mat-cab/Viridian-Shield/kicad/ViridianShield.kicad_pcb

## KiCad design kicad/ViridianShield.kicad_pcb (2021-05-29)

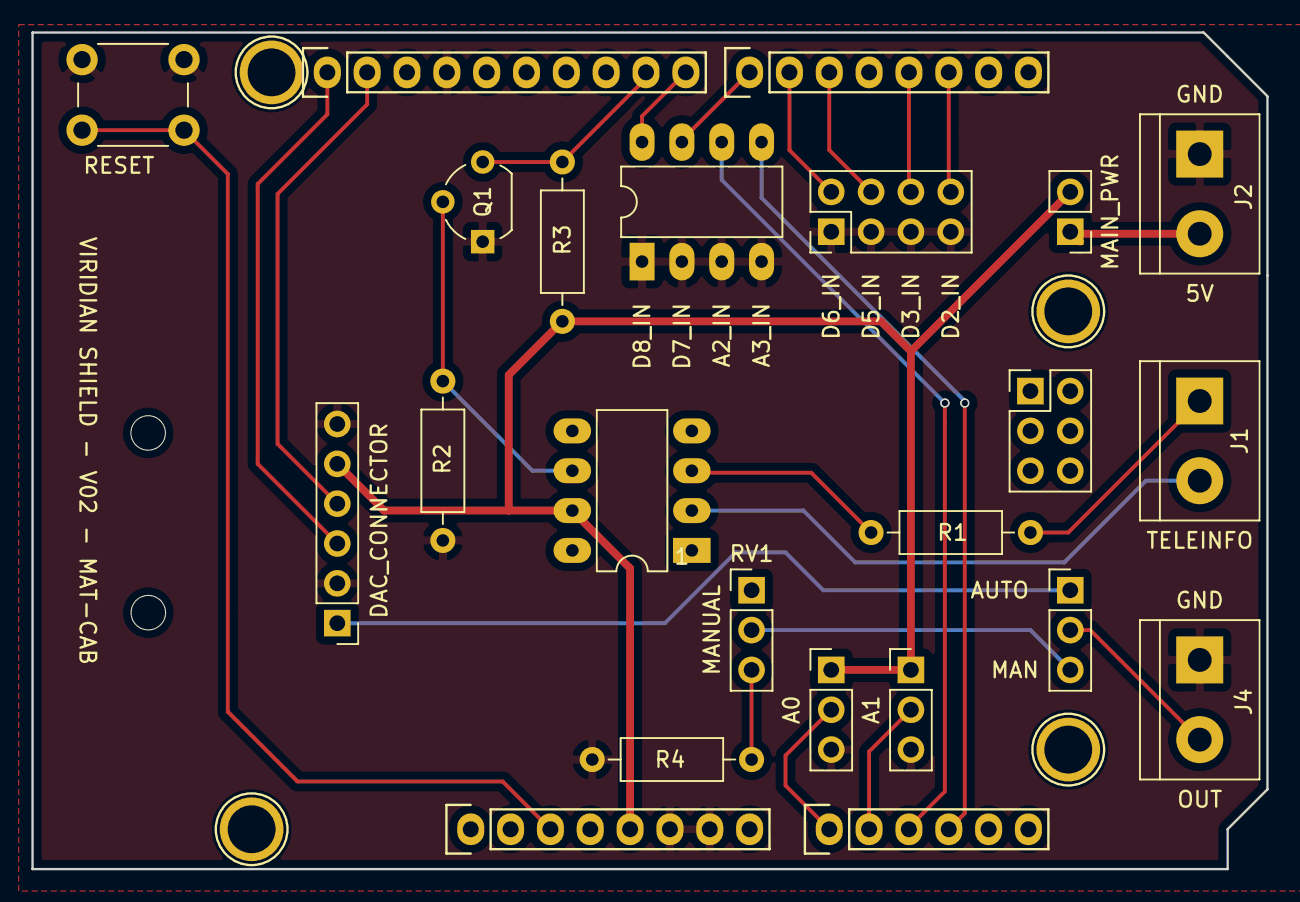
[picture p1: board ViridianShield.kicad_pcb from above]

Board: 2 copper layers, 78.7 x 53.3 mm, 27 parts (0 on the bottom side), 25 nets.

Parts:
J1: TELEINFO_INPUT; TerminalBlock_bornier-2_P5.08mm
J2: POWER_INPUT; TerminalBlock_bornier-2_P5.08mm
J3: DAC_MODULE; PinHeader_1x06_P2.54mm_Vertical
J4: VIRIDIAN_CONNECTOR; TerminalBlock_bornier-2_P5.08mm
P1: Power; Socket_Strip_Arduino_1x08
P2: Analog; Socket_Strip_Arduino_1x06
P3: Digital; Socket_Strip_Arduino_1x10
P4: Digital; Socket_Strip_Arduino_1x08
P5, P6, P7, P8: CONN_01X01; Arduino_1pin
P9: Conn_02x03_Odd_Even; PinHeader_2x03_P2.54mm_Vertical
Q1: 2N7000; TO-92_Wide
R1: 1.6k; R_Axial_DIN0207_L6.3mm_D2.5mm_P10.16mm_Horizontal
R2, R3: 10k; R_Axial_DIN0207_L6.3mm_D2.5mm_P10.16mm_Horizontal
R4: 240; R_Axial_DIN0207_L6.3mm_D2.5mm_P10.16mm_Horizontal
RV1: MANUAL_INPUT; PinHeader_1x03_P2.54mm_Vertical
RV2: A0_INPUT; PinHeader_1x03_P2.54mm_Vertical
RV3: A1_INPUT; PinHeader_1x03_P2.54mm_Vertical
SW1: INTERNAL_SWITCHES; DIP-8_W7.62mm_LongPads
SW2: D2-6_INPUT_SWITCHES; PinHeader_2x04_P2.54mm_Vertical_OtherPinAlloc
SW3: MAIN_POWER_SWITCH; PinHeader_1x02_P2.54mm_Vertical
SW4: AUTO_MANUAL_SWITCH; PinHeader_1x03_P2.54mm_Vertical
SW5: RESET_SWITCH; SW_PUSH_6mm
U1: SFH620A-1; DIP-8-4_W7.62mm_LongPads

Connections:
+5V: J3.5, P1.5, R3.1, RV2.1, RV3.1, SW3.2, U1.4
/A0: P2.1, RV2.2
/A1: P2.2, RV3.2
/A2: P2.3, SW1.6
/A3: P2.4, SW1.5
/D2: P4.6, SW2.5
/D3: P4.5, SW2.6
/D5: P4.3, SW2.7
/D6: P4.2, SW2.8
/D7: P4.1, SW1.7
/D8: P3.10, SW1.8
/D9: P3.9, Q1.3, R3.2
/MANUAL_OUTPUT: RV1.2, SW4.3
/RESET: P1.3, SW5.2
/SCL: J3.3, P3.1
/SDA: J3.4, P3.2
GND: J2.1, J3.2, J3.6, J4.1, P1.6, P1.7, P3.4, Q1.1, R2.2, R4.2, RV2.3, RV3.3, SW1.1, SW1.2, SW1.3, SW1.4, SW2.1, SW2.2, SW2.3, SW2.4, SW5.1
unnamed: J1.1, R1.2
unnamed: J1.2, U1.1
unnamed: J2.2, SW3.1
unnamed: J3.1, SW4.1
unnamed: J4.2, SW4.2
unnamed: Q1.2, R2.1, U1.3
unnamed: R1.1, U1.2
unnamed: R4.1, RV1.3
