mat-cab/Viridian-Shield/(threads)

Thread 1 (2020-12-15):

Shield rev 01 does not work with Arduino Mega

mat-cab, 2020-12-15:
For DAC I2C communication on Arduino Uno, pins A4 and A5 are used as SDA/SCL.

However, for Arduino Mega, those pins are not linked to SDA/SCL. Therefore the I2C communication between the base board and the shield fails.

In case a rev 02 is made, DAC I2C communication shall be directly connected to SCL/SDA ports (next to digital inputs).
This should allow the shield to work on both the Uno and the Mega.

mat-cab, 2021-05-29:
This should be fixed for the DAC with c582062e54fc54b1a7abfef3e9d56dcda2819370

However, Rev 02 of the board is using pin 9 with softwareSerial, which is not compliant with MEGA

Thread 2 (2020-12-27):

Teleinfo not properly received on Rev 01

mat-cab, 2020-12-27:
It seems that with R1 at 4.7K, the teleinfo is not properly received with a Linky.
Tested with an older electricity meter, 4.7K is OK.

mat-cab, 2020-12-27:
Replacement of R1 with 1.6K to be tested soon

mat-cab, 2021-05-29:
Fixed on Rev 02 of the board: new value is 1.6k

Closed 2021-05-29.
