mat-cab/Viridian-Shield/(commit log)

2020-12-15 kicad: Added version 01 of schematics
    [ViridianShield.kicad_pcb, ViridianShield.sch]
2020-12-15 inputs: correction in read function
    digitalRead does not return bool but LOW/HIGH
    [inputs.cpp]
2020-12-15 debug: Correction for MEGA
    Should use Serial3, otherwise SDA (I2C) pin is also used
2020-12-15 timer: creation of class to handle long cycles
2020-12-15 viridian: now new current applies immediately
    Also changed the debug messages with the module name
2020-12-15 viridian: add message log in case of undercharging
2020-12-15 main: addition of a delay at the end of setup
    This allows the home power grid to fuly come back up
2020-12-15 main: corrected ADPS behavior
    After second reading, ADPS is not stored
    [main.cpp]
2020-12-15 main: Changed logic in case of ADPS
2020-12-15 main: added condition to start charge
2020-12-15 viridian: Added check of current change
2020-12-15 viridian: correction for currentChanged definition
    [viridian.cpp]
2020-12-15 main: no current change for less than 1 amp
2020-12-15 teleinfo: removed external library and created own
    External library is using SoftwareSerial
    which is not compatible with real HardwareSerial
    [main.cpp, teleinfo.cpp, teleinfo.h]
2020-12-15 main: added debug message for offline charger
2020-12-15 teleinfo: corrected string equality checks
    [teleinfo.cpp]
2020-12-15 teleinfo: added/corrected expected labels
    [teleinfo.cpp, teleinfo.h]
2020-12-15 teleinfo: corrected overflow detection
    [teleinfo.cpp]
2020-12-15 main: added debug message before charge change
2020-12-15 viridian: corrected Q computation
    Math was wrong!
    [viridian.cpp]
2020-12-27 main: added charging car input
    When the car is not charging, set a nominal charge to 10A
2021-02-26 main: added initial charge delay
    This allows the general power consumption to settle before adjusting
2021-02-26 main: Correction of wrong logic for car charging
    [main.cpp]
2021-02-26 main: Added delay after charge adaptation
2021-02-26 main: Corrected control for minimum current change
    [main.cpp]
2021-05-29 kicad: Shield design evolution
    [ViridianShield.kicad_pcb, ViridianShield.sch]
2021-05-29 teleinfo: fixed warning message in initialization
    [teleinfo.h]
2021-05-29 teleinfo: changed HardwareSerial to SoftwareSerial
    This is better given that serial speeds are very slow
    it also allows to use HardwareSerial to perform debugging on Arduino Uno
2021-05-29 gitignore: Updated to exclude kicad files
2021-05-29 kicad: V02 Shield update
    [ViridianShield.kicad_pcb, ViridianShield.sch]
2021-07-11 inputs: Corrected initialization for uno and V02 shield
    [inputs.cpp]
2021-07-11 main: minor cosmetic corrections
    [main.cpp]
